xiaoyangxianshen664/Modbus_RTU_Node/firmware/stm32f429/User/main.c

#include "stm32f4xx_hal.h"
#include "./LED/LED.h"
#include "./Key/Key.h"
#include "./Usart/Usart.h"
#include "./TIM7/TIM7.h"
#include "./SysTick/SysTick.h"
#include "./485/bsp_485.h"
#include "modbus_transport.h"
#include "freertos_demo.h"
#include "./ADC/ADC_Multi.h"
#include "./IWDG/iwdg.h"
#include "./Config/config_storage.h"
#include <stdio.h>

/**
 * @brief  关闭 WiFi 模块，释放 SDIO 外设资源
 * @param  无
 * @return 无
 * @note   开发板上的 WiFi 模块与 SD 卡接口存在资源/供电关联。
 *         PB13 拉低后关闭 WiFi，SDIO 才能稳定识别 SD 卡。
 */
static void WIFI_PDN_Init(void)
{
  GPIO_InitTypeDef gpio = {0};                         // PB13 GPIO 配置结构体

  __HAL_RCC_GPIOB_CLK_ENABLE();                       // 开启 GPIOB 时钟
  gpio.Pin   = GPIO_PIN_13;                            // WiFi 电源控制脚
  gpio.Mode  = GPIO_MODE_OUTPUT_PP;                    // 推挽输出
  gpio.Pull  = GPIO_PULLUP;                             // 保持默认高电平状态稳定
  gpio.Speed = GPIO_SPEED_FAST;                        // 快速 GPIO 输出
  HAL_GPIO_Init(GPIOB, &gpio);                         // 应用 PB13 配置
  HAL_GPIO_WritePin(GPIOB, GPIO_PIN_13, GPIO_PIN_RESET); // 拉低，关闭 WiFi 模块
}

/* ════════════════════════════════════════════════════════════
 * main — 阶段 3 FreeRTOS Modbus RTU 从站入口
 *
 * 原型：int main(void)
 * 形参：无
 * 返值：正常情况下不会返回
 *
 * 数据流：USART2 中断收字节 → TIM4 判断帧边界并通知 ModbusTask
 *         → ModbusTask 复制完整帧 → 纯 C 协议层解析 → RS485 响应
 *
 * 调用示例：
 *   main();  // 复位后由启动文件调用
 * ════════════════════════════════════════════════════════════ */
int main(void)
{
  HAL_Init();                                         // 初始化 HAL、NVIC 分组和默认 SysTick
  diagnostics_init();                                 // 在启动看门狗前，记录上一次复位原因
  SysTick_Init();                                     // 配置 HSE 25MHz → 系统时钟 180MHz
  TIM7_Init();                                        // TIM7 提供 HAL 的 1ms 时基，避免与 FreeRTOS SysTick 冲突
  WIFI_PDN_Init();                                    // 关闭 WiFi，释放 SDIO 相关资源
  LED_Init();                                         // 初始化板载状态灯
  Key_Init();                                         // 初始化按键（保留供后续调试使用）

  Usart1_Init(115200);                                // USART1：调试串口，115200 8N1，供 printf 使用
  Usart1_DMA_Init();                                  // 初始化 USART1 收发 DMA
  HAL_UART_AbortReceive(&huart1);                     // 终止 USART1 初始化时启动的单字节 IT 接收
  HAL_UART_Receive_DMA(&huart1, dma_rx_buf, DMA_RX_BUF_SIZE); // 改用 DMA 接收 USART1 调试数据
  __HAL_UART_CLEAR_IDLEFLAG(&huart1);                 // 清除切换接收模式时可能残留的 IDLE 标志

  BSP_485_Init();                                     // USART2 + PB8 DE/RE，9600 8E1，默认进入接收模式
  modbus_transport_init();                            // TIM4 计量 T1.5/T3.5，判断帧内超时和帧结束
  ADC_Multi_Init();                                   // 阶段 4：启动 PC3 + PA4 两路 ADC DMA 扫描
  log_storage_init();                                 // 阶段 5：初始化 RTC 并挂载 SD 文件系统
  config_storage_init();                              // 阶段 7：初始化 W25Q256 配置存储
  IWDG_Config(IWDG_PRESCALER_256, 625U);              // 阶段 6：按典型 40kHz LSI 约 4 秒超时

  printf("Modbus RTU Node - ADC DMA stage 6!\r\n");  // 调度器启动前从 USART1 输出一次启动信息

  freertos_demo();                                    // 创建四个业务任务并启动 FreeRTOS 调度器

  while (1)
  {
    // 调度器正常启动后不会返回；若堆不足导致启动失败，则停在这里便于调试。
  }
}
