xiaoyangxianshen664/Modbus_RTU_Node/RCT6硬件测试/RCT6项目代码/Dirvers/BSP/bsp.c

#include "main.h"

void bsp_Init(void){

	HAL_Init();
	/* Configure the system clock to 72 MHz */
    SystemClock_Config();   
    /* 初始化 printf 使用的 USART1。 */
    MyPrintfInit();

    GPIO_Init();
    LED_Init();
    KEY_Init();

}
