xiaoyangxianshen664/Modbus_RTU_Node/RCT6硬件测试/RCT6项目代码/Users/main.h

/**
  ******************************************************************************
  * @file    Templates/Inc/main.h 
  * @author  MCD Application Team
  * @brief   Header for main.c module
  ******************************************************************************
  * @attention
  *
  * <h2><center>&copy; Copyright (c) 2016 STMicroelectronics.
  * All rights reserved.</center></h2>
  *
  * This software component is licensed by ST under BSD 3-Clause license,
  * the "License"; You may not use this file except in compliance with the
  * License. You may obtain a copy of the License at:
  *                        opensource.org/licenses/BSD-3-Clause
  *
  ******************************************************************************
  */
  
/* Define to prevent recursive inclusion -------------------------------------*/
#ifndef __MAIN_H
#define __MAIN_H

/* Includes ------------------------------------------------------------------*/
#include "stm32f1xx_hal.h"
#include "bsp.h"
#include "stdio.h"
#include "stdbool.h"
/* Exported types ------------------------------------------------------------*/

/* Exported constants --------------------------------------------------------*/

/* Exported macro ------------------------------------------------------------*/


/* Exported functions ------------------------------------------------------- */

#endif /* __MAIN_H */

/************************ (C) COPYRIGHT STMicroelectronics *****END OF FILE****/
