xiaoyangxianshen664/Modbus_RTU_Node/RCT6硬件测试/RCT6项目代码/Dirvers/BSP/gpio.c

#include "main.h"

void GPIO_Init(void){

    /*PA8 配置为推挽输出*/
    GPIO_InitTypeDef GPIO_InitStruct = {0};
    __HAL_RCC_GPIOB_CLK_ENABLE();
    /*上电默认高电平*/
    HAL_GPIO_WritePin(GPIOB, GPIO_PIN_8, GPIO_PIN_SET);
    GPIO_InitStruct.Pin = GPIO_PIN_8;
    GPIO_InitStruct.Mode = GPIO_MODE_OUTPUT_PP;
    GPIO_InitStruct.Pull = GPIO_NOPULL;
    GPIO_InitStruct.Speed = GPIO_SPEED_FREQ_MEDIUM;
    HAL_GPIO_Init(GPIOB, &GPIO_InitStruct);
}
