xiaoyangxianshen664/Modbus_RTU_Node/RCT6硬件测试/RCT6项目代码/Dirvers/SYSTEM/delay.c

#include "delay.h"

/*
*********************************************************************************************************
*    函 数 名: bsp_DelayUS
*    功能说明: us级延迟。 必须在滴答定时器启动后才能调用此函数（HAL库HAL_init自动启动滴答定时器）
*    形    参:  n : 延迟长度，单位1 us
*    返 回 值: 无
*********************************************************************************************************
*/
void bsp_DelayUS(uint32_t n)
{
    uint32_t ticks;
    uint32_t told;
    uint32_t tnow;
    uint32_t tcnt = 0;
    uint32_t reload;
       
	reload = SysTick->LOAD;                      /* 获取自动重装值 */              
    ticks = n * (SystemCoreClock / 1000000);	 /* 需要的节拍数 */  
    
    tcnt = 0;
    told = SysTick->VAL;                         /* 刚进入时的计数器值 */

    while (1)
    {
        tnow = SysTick->VAL;    
        if (tnow != told)
        {    
            /* SYSTICK是一个递减的计数器 */    
            if (tnow < told)
            {
                tcnt += told - tnow;    
            }
            /* 重新装载递减 */
            else
            {
                tcnt += reload - tnow + told;    
            }        
            told = tnow;

            /* 时间超过/等于要延迟的时间,则退出 */
            if (tcnt >= ticks)
            {
            	break;
            }
        }  
    }
} 

/*精度高于HAL_Delay*/
void bsp_DelayMS(uint32_t i){

    while(i){
        bsp_DelayUS(1000);
        i--;
    }

}
