xiaoyangxianshen664/Modbus_RTU_Node/(commit log)

2026-08-16 chore: 初始化 Modbus RTU 数据采集节点项目结构
2026-08-21 Complete Modbus RTU protocol stage 1
2026-08-21 Document stage 1 progress in README
2026-08-22 Complete stage 2 bare-metal Modbus RTU transport
2026-08-23 Complete stage 3 FreeRTOS Modbus task integration
2026-08-23 Update README for stage 3 completion
2026-08-25 Complete stage 4 ADC DMA acquisition
2026-08-26 Complete stage 5 RTC SD logging and NTC conversion
2026-08-26 Document stage 5 RTC SD logging progress
2026-08-26 Complete stage 6 watchdog diagnostics
2026-08-26 Document stage 6 completion and stage 7 plan
2026-08-27 Complete stage 7 W25Q256 configuration persistence
2026-08-27 Document stage 7 completion
2026-08-27 Document stage 8 validation and stage 9 plan
